tminh-U/DIY-Haptic-Motor-for-Pedals/BUILD_LOG.md

# 16/8/2026

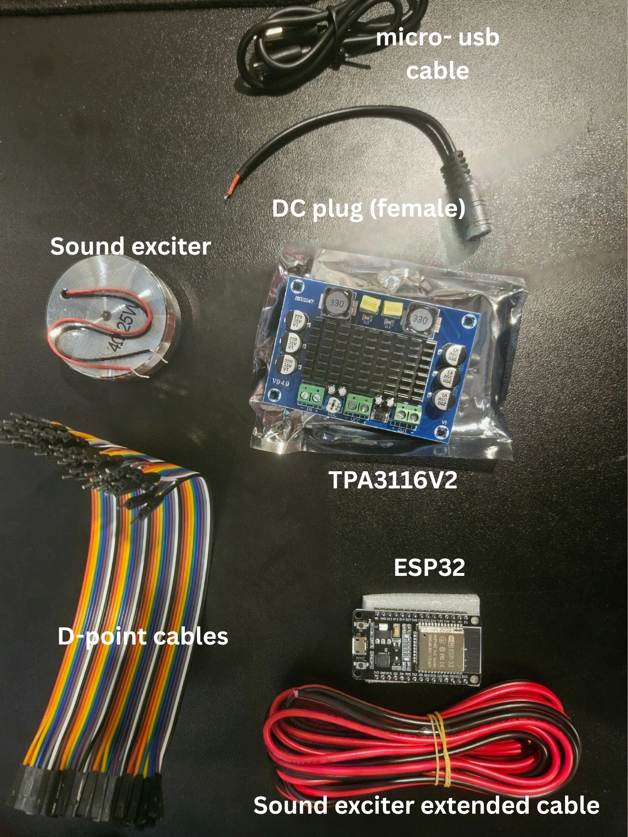
[picture p1: Image/1682026-arrived_items.png]
items


**Today arrived items** :
- ESP32-DEVKIT-V1
- TPA3116V2 (XH-M542)
- DC jack (female)
- Sound exciter extended cable
- Micro-usb cable
- D-point cables

## Today works :

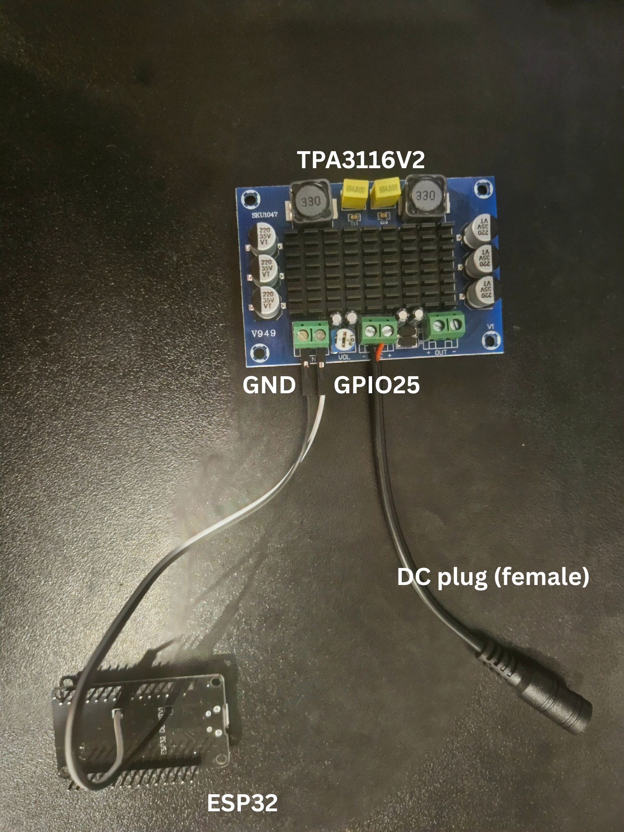
[picture p2: Image/1682026-connecting_board.png]


- Connecting ESP32 and the amply through D-point cables
- Connecting the female DC jack with TPA3116V2

# 18/8/2026

**Today arrived items** :
- DC 12V - 3A cable
- 40mm bass transducer
- Amplifier case
- Wire connector

## Today works :

### Connected all of the components.
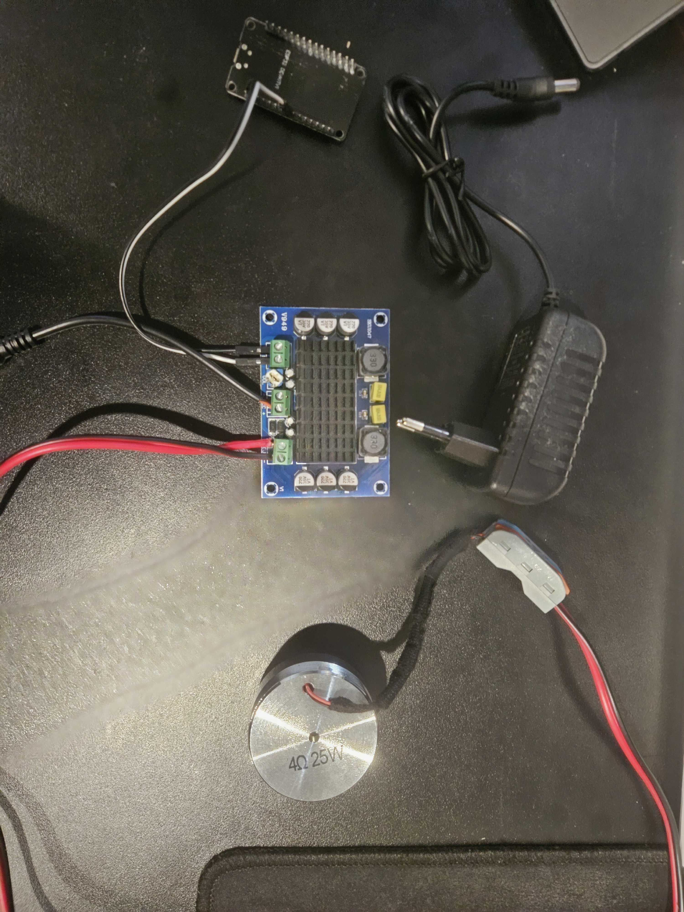
[picture p3: Image/1882026-complete_components.jpg]


### Testing 

- ABS with Amplitude modulation (60Hz - 12Hz) : [Here](https://youtube.com/shorts/pjtzisKoqhs?feature=share)
- **Comment** : Weak intensity even at max amplitude due to the sound exciter's physical limitations. 

# 21/8/2026

**Today arrived items** : Nothing yet
## Today works :

### Complete the firmware for ESP32

### Testing all effects

- Demo video (ABS) : [Here](https://youtube.com/shorts/HPPclNWR_eQ)
- Demo video (slip effect) : [Here](https://youtube.com/shorts/F_2Ib3Tkiu4?feature=share)
- Demo video (road effect) : [Here](https://youtube.com/shorts/F_2Ib3Tkiu4?feature=share)
