tminh-U/DIY-Haptic-Motor-for-Pedals/(commit log)

2026-08-18 Update [18/8/2026]
    Update ESP32 firmware, telemetry pipeline, and documentation
    - Update README.md: Add EMA smoothing table, Pacejka curve rationale, and academic references
    - Add telemetry bridge: 120Hz shared memory reader from game to ESP32 via Serial
    - Add ESP32 firmware: 5kHz Hardware Timer DAC synthesizer with ABS, Road, and Tire Slip effects
    [structed_file.h, test_template.cpp]
2026-08-19 Updating Software/Hardware implementation and complete get_telemetry, also recalibrate the frequency for ESP32
2026-08-22 [22/8/2026] Big update
    App :
    - Remove CLI version
    - Recalculate ABS and Slip function
    - Adding Python app for Assetto Corsa/Content manager
    - Change from Wheelslip to NDslip, slipratio, etc using Assetto Corsa python API
    - Adding Assetto Corsa Competizone support
    - Adding auto-detect using handshake
    Firmware :
    - Fixing random fatal panic due to conflicting memory access between 2 cores
    - Adding return function when the app ask for ID
    [app_gui.cpp, haptic_firmware.ino, structed_file_AC.h, structed_file_ACC.h]
2026-08-22 Updating prototype folder
2026-09-06 [6/9/2026] Big Update
    - New get_telemetry UI (Big thanks to Codex)
    - Adding in-app firmware flasher and updater
    - New installer
    - Volume equalizer for the app
    - Changing app name from get_telemetry to Haptic Brake Control
    - Adding start with windows and minimize to tray function
2026-09-10 fix: prevent fatal panic during effect calculation
    [haptic_firmware.ino]
2026-09-11 Change ESP32 data transfer's timeout
2026-10-07 fix: prevent haptic dropouts and gain saturation
    Clamp slip and isolate diagnostic faults to keep feedback alive.
    Wait for serial lines to prevent false disconnects.
    Scale waveforms, detect brownouts, and retain legacy packets.
    Release 1.04.
    [app_gui.cpp, haptic_firmware.ino]
